TheBl0ckedchain/snake_hardware/ros2_ws/src/snakebot_description/meshes/seg2.stl

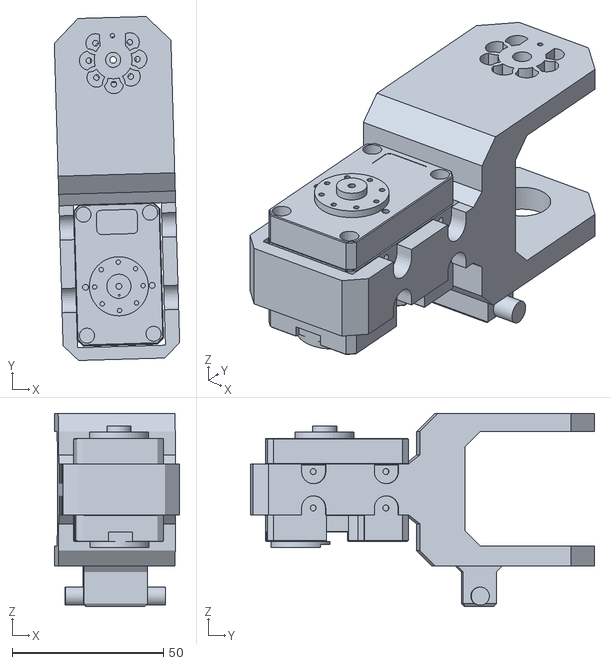
[picture p1: CAD file, 2026-10-05]
ros2_ws/src/snakebot_description/meshes/seg2.stl
41.4 x 113.5 x 63.8
