TheBl0ckedchain/snake_hardware/ros2_ws/src/snakebot_description/meshes/tail.stl

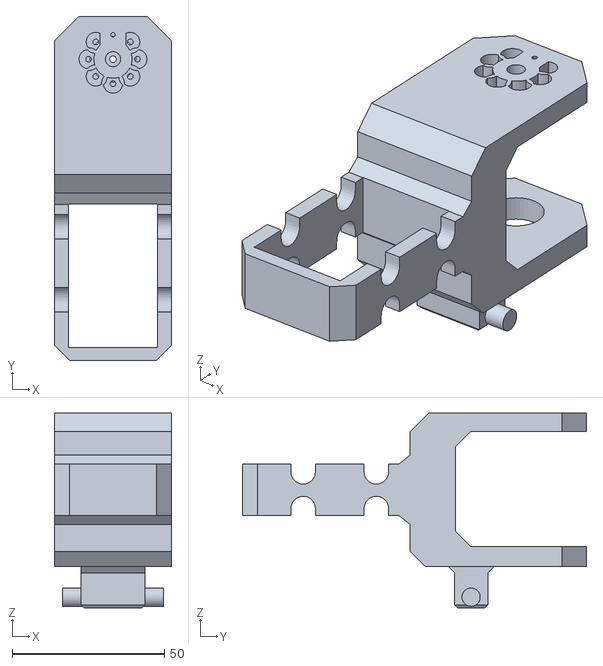
[picture p2: CAD file, 2026-10-05]
ros2_ws/src/snakebot_description/meshes/tail.stl
38.5 x 112.9 x 63.9
