TheBl0ckedchain/snake_hardware/ros2_ws/src/snakebot_description/meshes/base_link.stl

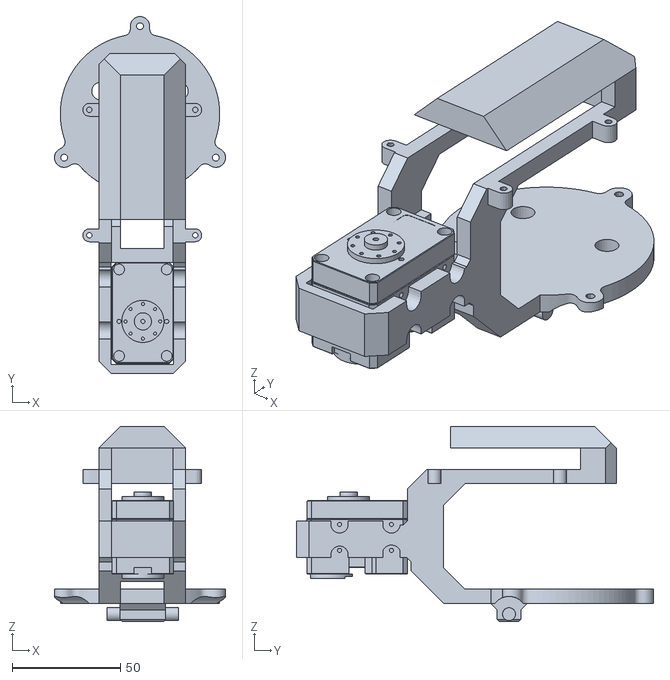
[picture p3: CAD file, 2026-10-05]
ros2_ws/src/snakebot_description/meshes/base_link.stl
79.1 x 165.1 x 90.3
