TheBl0ckedchain/snake_hardware/(list of files, cad)

Other CAD files:
ros2_ws/src/snakebot_description/meshes/seg1.stl
ros2_ws/src/snakebot_description/meshes/seg5.stl
ros2_ws/src/snakebot_description/meshes/seg3.stl
ros2_ws/src/snakebot_description/meshes/seg4.stl
