TheBl0ckedchain/snake_hardware/ros2_ws/src/snakebot_description/urdf/snakebot_core.xacro

<?xml version="1.0"?>
<!-- AUTO-GENERATED by gen.py from the Fusion meshes. Edit snakebot.urdf.xacro for settings. -->
<robot xmlns:xacro="http://www.ros.org/wiki/xacro">

  <link name="base_link">
    <inertial>
      <origin xyz="0.051785 0.000018 0.046945" rpy="0 0 0"/>
      <mass value="${m_base_link}"/>
      <inertia ixx="9.0997e-05" iyy="2.9248e-04" izz="2.3976e-04" ixy="-1.4474e-06" ixz="-1.3283e-05" iyz="6.0904e-07"/>
    </inertial>
    <visual>
      <origin xyz="0.000000 0.000000 0.000000" rpy="0 0 ${-pi/2}"/>
      <geometry><mesh filename="file://$(find snakebot_description)/meshes/base_link.stl" scale="0.001 0.001 0.001"/></geometry>
      <material name="${color_head}"/>
    </visual>
    <collision>
      <origin xyz="0.000000 0.000000 0.000000" rpy="0 0 ${-pi/2}"/>
      <geometry><mesh filename="file://$(find snakebot_description)/meshes/base_link.stl" scale="0.001 0.001 0.001"/></geometry>
    </collision>
  </link>

  <link name="seg1">
    <inertial>
      <origin xyz="-0.049115 -0.001257 -0.022258" rpy="0 0 0"/>
      <mass value="${m_seg1}"/>
      <inertia ixx="2.8940e-05" iyy="8.5347e-05" izz="7.5605e-05" ixy="-1.4134e-06" ixz="3.7939e-06" iyz="9.2217e-08"/>
    </inertial>
    <visual>
      <origin xyz="-0.001587 0.000408 -0.064200" rpy="0 0 ${-pi/2}"/>
      <geometry><mesh filename="file://$(find snakebot_description)/meshes/seg1.stl" scale="0.001 0.001 0.001"/></geometry>
      <material name="${color_body}"/>
    </visual>
    <collision>
      <origin xyz="-0.001587 0.000408 -0.064200" rpy="0 0 ${-pi/2}"/>
      <geometry><mesh filename="file://$(find snakebot_description)/meshes/seg1.stl" scale="0.001 0.001 0.001"/></geometry>
    </collision>
  </link>

  <link name="seg2">
    <inertial>
      <origin xyz="-0.048999 -0.001339 -0.022228" rpy="0 0 0"/>
      <mass value="${m_seg2}"/>
      <inertia ixx="2.8940e-05" iyy="8.5347e-05" izz="7.5605e-05" ixy="-1.4134e-06" ixz="3.7939e-06" iyz="9.2217e-08"/>
    </inertial>
    <visual>
      <origin xyz="0.073255 0.002218 -0.063800" rpy="0 0 ${-pi/2}"/>
      <geometry><mesh filename="file://$(find snakebot_description)/meshes/seg2.stl" scale="0.001 0.001 0.001"/></geometry>
      <material name="${color_body}"/>
    </visual>
    <collision>
      <origin xyz="0.073255 0.002218 -0.063800" rpy="0 0 ${-pi/2}"/>
      <geometry><mesh filename="file://$(find snakebot_description)/meshes/seg2.stl" scale="0.001 0.001 0.001"/></geometry>
    </collision>
  </link>

  <link name="seg3">
    <inertial>
      <origin xyz="-0.048998 -0.001262 -0.022198" rpy="0 0 0"/>
      <mass value="${m_seg3}"/>
      <inertia ixx="2.8939e-05" iyy="8.5348e-05" izz="7.5605e-05" ixy="-1.3948e-06" ixz="3.7939e-06" iyz="9.0963e-08"/>
    </inertial>
    <visual>
      <origin xyz="0.147982 0.004171 -0.063400" rpy="0 0 ${-pi/2}"/>
      <geometry><mesh filename="file://$(find snakebot_description)/meshes/seg3.stl" scale="0.001 0.001 0.001"/></geometry>
      <material name="${color_body}"/>
    </visual>
    <collision>
      <origin xyz="0.147982 0.004171 -0.063400" rpy="0 0 ${-pi/2}"/>
      <geometry><mesh filename="file://$(find snakebot_description)/meshes/seg3.stl" scale="0.001 0.001 0.001"/></geometry>
    </collision>
  </link>

  <link name="seg4">
    <inertial>
      <origin xyz="-0.049109 -0.001245 -0.022168" rpy="0 0 0"/>
      <mass value="${m_seg4}"/>
      <inertia ixx="2.8938e-05" iyy="8.5349e-05" izz="7.5605e-05" ixy="-1.3578e-06" ixz="3.7940e-06" iyz="8.8479e-08"/>
    </inertial>
    <visual>
      <origin xyz="0.222600 0.006022 -0.063000" rpy="0 0 ${-pi/2}"/>
      <geometry><mesh filename="file://$(find snakebot_description)/meshes/seg4.stl" scale="0.001 0.001 0.001"/></geometry>
      <material name="${color_body}"/>
    </visual>
    <collision>
      <origin xyz="0.222600 0.006022 -0.063000" rpy="0 0 ${-pi/2}"/>
      <geometry><mesh filename="file://$(find snakebot_description)/meshes/seg4.stl" scale="0.001 0.001 0.001"/></geometry>
    </collision>
  </link>

  <link name="seg5">
    <inertial>
      <origin xyz="-0.049078 -0.001138 -0.022238" rpy="0 0 0"/>
      <mass value="${m_seg5}"/>
      <inertia ixx="2.8934e-05" iyy="8.5353e-05" izz="7.5605e-05" ixy="-1.2725e-06" ixz="3.7941e-06" iyz="8.2740e-08"/>
    </inertial>
    <visual>
      <origin xyz="0.297361 0.007873 -0.062700" rpy="0 0 ${-pi/2}"/>
      <geometry><mesh filename="file://$(find snakebot_description)/meshes/seg5.stl" scale="0.001 0.001 0.001"/></geometry>
      <material name="${color_body}"/>
    </visual>
    <collision>
      <origin xyz="0.297361 0.007873 -0.062700" rpy="0 0 ${-pi/2}"/>
      <geometry><mesh filename="file://$(find snakebot_description)/meshes/seg5.stl" scale="0.001 0.001 0.001"/></geometry>
    </collision>
  </link>

  <link name="tail">
    <inertial>
      <origin xyz="-0.033705 -0.000052 -0.023434" rpy="0 0 0"/>
      <mass value="${m_tail}"/>
      <inertia ixx="3.0193e-05" iyy="5.9335e-05" izz="4.8131e-05" ixy="1.8217e-13" ixz="1.8038e-06" iyz="-1.9926e-14"/>
    </inertial>
    <visual>
      <origin xyz="0.372127 0.009478 -0.062300" rpy="0 0 ${-pi/2}"/>
      <geometry><mesh filename="file://$(find snakebot_description)/meshes/tail.stl" scale="0.001 0.001 0.001"/></geometry>
      <material name="${color_body}"/>
    </visual>
    <collision>
      <origin xyz="0.372127 0.009478 -0.062300" rpy="0 0 ${-pi/2}"/>
      <geometry><mesh filename="file://$(find snakebot_description)/meshes/tail.stl" scale="0.001 0.001 0.001"/></geometry>
    </collision>
  </link>

  <joint name="joint1" type="revolute">
    <parent link="base_link"/>
    <child link="seg1"/>
    <origin xyz="0.001587 -0.000408 0.064200" rpy="0 0 0"/>
    <axis xyz="0 0 1"/>
    <limit lower="${-joint_limit}" upper="${joint_limit}" effort="${joint_effort}" velocity="${joint_velocity}"/>
    <dynamics damping="${joint_damping}" friction="${joint_friction}"/>
  </joint>

  <joint name="joint2" type="revolute">
    <parent link="seg1"/>
    <child link="seg2"/>
    <origin xyz="-0.074842 -0.001809 -0.000400" rpy="0 0 0"/>
    <axis xyz="0 0 1"/>
    <limit lower="${-joint_limit}" upper="${joint_limit}" effort="${joint_effort}" velocity="${joint_velocity}"/>
    <dynamics damping="${joint_damping}" friction="${joint_friction}"/>
  </joint>

  <joint name="joint3" type="revolute">
    <parent link="seg2"/>
    <child link="seg3"/>
    <origin xyz="-0.074728 -0.001953 -0.000400" rpy="0 0 0"/>
    <axis xyz="0 0 1"/>
    <limit lower="${-joint_limit}" upper="${joint_limit}" effort="${joint_effort}" velocity="${joint_velocity}"/>
    <dynamics damping="${joint_damping}" friction="${joint_friction}"/>
  </joint>

  <joint name="joint4" type="revolute">
    <parent link="seg3"/>
    <child link="seg4"/>
    <origin xyz="-0.074618 -0.001851 -0.000400" rpy="0 0 0"/>
    <axis xyz="0 0 1"/>
    <limit lower="${-joint_limit}" upper="${joint_limit}" effort="${joint_effort}" velocity="${joint_velocity}"/>
    <dynamics damping="${joint_damping}" friction="${joint_friction}"/>
  </joint>

  <joint name="joint5" type="revolute">
    <parent link="seg4"/>
    <child link="seg5"/>
    <origin xyz="-0.074761 -0.001851 -0.000300" rpy="0 0 0"/>
    <axis xyz="0 0 1"/>
    <limit lower="${-joint_limit}" upper="${joint_limit}" effort="${joint_effort}" velocity="${joint_velocity}"/>
    <dynamics damping="${joint_damping}" friction="${joint_friction}"/>
  </joint>

  <joint name="joint6" type="revolute">
    <parent link="seg5"/>
    <child link="tail"/>
    <origin xyz="-0.074766 -0.001606 -0.000400" rpy="0 0 0"/>
    <axis xyz="0 0 1"/>
    <limit lower="${-joint_limit}" upper="${joint_limit}" effort="${joint_effort}" velocity="${joint_velocity}"/>
    <dynamics damping="${joint_damping}" friction="${joint_friction}"/>
  </joint>

  <!-- Raspberry Pi 5 (placed on top of the head hood; box approximation) -->
  <joint name="pi5_joint" type="fixed">
    <parent link="base_link"/>
    <child link="pi5"/>
    <origin xyz="0.087012 -0.000089 0.103085" rpy="0 0 0"/>
  </joint>
  <link name="pi5">
    <inertial>
      <mass value="${m_pi5}"/>
      <inertia ixx="${m_pi5*(0.056**2+0.017**2)/12}" iyy="${m_pi5*(0.085**2+0.017**2)/12}" izz="${m_pi5*(0.085**2+0.056**2)/12}" ixy="0" ixz="0" iyz="0"/>
    </inertial>
    <visual>
      <geometry><box size="0.085 0.056 0.017"/></geometry>
      <material name="pcb_green"/>
    </visual>
  </link>

  <!-- YDLIDAR G2 on the round mount plate of the head -->
  <joint name="lidar_joint" type="fixed">
    <parent link="base_link"/>
    <child link="lidar"/>
    <origin xyz="0.097492 0.000960 0.019335" rpy="0 0 0"/>
  </joint>
  <link name="lidar">
    <inertial>
      <origin xyz="0 0 ${lidar_body_h/2}"/>
      <mass value="${m_lidar}"/>
      <inertia ixx="${m_lidar*(3*lidar_body_r**2+lidar_body_h**2)/12}" iyy="${m_lidar*(3*lidar_body_r**2+lidar_body_h**2)/12}" izz="${m_lidar*lidar_body_r**2/2}" ixy="0" ixz="0" iyz="0"/>
    </inertial>
    <visual>
      <origin xyz="0 0 ${lidar_body_h/2}"/>
      <geometry><cylinder radius="${lidar_body_r}" length="${lidar_body_h}"/></geometry>
      <material name="black"/>
    </visual>
  </link>

  <!-- laser frame: scan plane. x = lidar zero angle (G2: direction of the cable outlet) -->
  <joint name="laser_joint" type="fixed">
    <parent link="lidar"/>
    <child link="laser"/>
    <origin xyz="0 0 ${lidar_scan_height}" rpy="0 0 ${lidar_yaw}"/>
  </joint>
  <link name="laser"/>

</robot>
