TheBl0ckedchain/snake_hardware/ros2_ws/src/snake_driver/config/dxl.yaml

# Dynamixel joint driver. Joints 1-6 run head -> tail; 0 rad = straight (raw position 2048).
dxl_node:
  ros__parameters:
    port: /dev/dynamixel
    baudrate: 1000000          # set by scripts/dxl_configure.py
    ids: [1, 2, 3, 4, 5, 6]
    joint_names: [joint1, joint2, joint3, joint4, joint5, joint6]   # as in snakebot_description
    rate_hz: 100.0             # /joint_states rate
    # Raw angle of each joint in the straight pose (scripts/calibrate_joints.py, 2026-10-05).
    zero_offset_deg: [-0.79, 0.85, -1.05, -0.88, -0.53, -0.54]

    # --- Safety. These are applied only when torque is enabled (via ~/enable). ---
    joint_limit_deg: 60.0      # clamp + servo position limits. Stops 2026-10-05: joint1 -70 (hits lidar UART adapter)/+95, others ~+/-100 deg
    profile_velocity_rpm: 30.0 # max joint speed the servo will plan (the gait in slither.py peaks near 7 rpm)
    profile_accel: 50          # raw units (214.577 rev/min^2 each); 0 = unlimited
    pwm_limit_pct: 70.0        # caps motor output, and so the torque, at this % of supply voltage
    current_limit_a: 1.5       # sustained |current| above this ...
    current_limit_time_s: 1.0  # ... for this long -> all torque off (XM430-W350 stalls at ~2.3 A @ 12 V)
    temp_limit_c: 70           # any joint at or above this -> all torque off (servo's own shutdown is 80)
