TheBl0ckedchain/snake_hardware/(commit log)

2026-10-03 install_system_deps: repair interrupted dpkg state before installing
2026-10-03 lidar.launch: start foxglove_bridge on :8765 for headless viewing
2026-10-04 lidar: crop scan to ±140° — rear wedge is blocked by the mounting joint
    The joint behind the G2 returns self-hits at 0.13-0.16 m that SLAM would
    read as an obstacle attached to the robot.
2026-10-04 Servo driver node (torque off by default) and 1 Mbps bus
    - scripts/dxl_configure.py: one-time EEPROM setup (baud 1 Mbps, return delay 0);
    writes no torque/goal registers. Already applied to IDs 1-6.
    - snake_driver/dxl_node: /joint_states at 100 Hz via sync read, /diagnostics at 1 Hz,
    /snake/joint_cmd for targets, ~/enable service. Starts torque off; on enable it applies
    PWM/position/profile limits and holds present position. Trips all torque off on sustained
    over-current, over-temperature, hardware error or lost comms.
    - slither.py and dxl_status.py default to /dev/dynamixel @ 1 Mbps.
    [dxl.yaml, dxl_configure.py, dxl_node.py, dxl_status.py, slither.py]
2026-10-04 Add stage-1 torque hold test (run by the user at the robot)
2026-10-04 Add stage-2 joint direction test (+5 deg per joint, one at a time)
2026-10-05 Add snakebot_description (URDF/meshes from Fusion export), as delivered
    [base_link.stl, controllers.yaml, materials.xacro, seg1.stl, seg2.stl, seg3.stl, seg4.stl, seg5.stl]
2026-10-05 Wire the CAD URDF into the real robot: robot.launch, gait node, e-stop
    - dxl_node: joints named joint1-6 as in snakebot_description; also accepts
    /snake_position_controller/commands (Float64MultiArray) so gait/NN nodes run
    unchanged on mock, Gazebo and the real servos.
    - snake_bringup/robot.launch.py: robot_state_publisher (URDF) + dxl_node + lidar
    (URDF supplies base_link->laser) + Foxglove.
    - snakebot_gait/serpenoid: A*sin(phi + i*beta) + gamma, live params, ramped
    amplitude/bias, clamped, Ctrl-C fades to straight.
    - scripts/torque_off.py: emergency torque off over the bus, no ROS needed.
    - install_system_deps.sh: ros2_control + ros2_controllers for mock mode.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
2026-10-05 Joint zero calibration: interactive read-only script + per-joint offsets in dxl_node
2026-10-05 Apply joint calibration: zero offsets, ±60° joint limit (driver, URDF, gait)
    Measured stops: joint1 -70/+95 deg, joints 2-6 about +/-100 deg. 60 deg keeps a
    10 deg margin on the tightest (joint1 negative side).
    [joint_calibration.yaml, snakebot.urdf.xacro]
2026-10-05 Verify joint 1 direction against URDF with the lidar; note joint1 collision
    [snakebot.urdf.xacro]
2026-10-05 Gait blends in from the actual pose; slither_run.sh for timed, recorded runs
    First real slither (A=0.2 rad, 0.5 Hz): head moved 5.5 cm forward in ~10 s by
    lidar ICP, joints tracked +/-11.2 of +/-11.5 deg, peak 0.14 A, max 37 C.
    The gait used to start from straight, snapping joints from their resting pose
    (up to 17 deg); it now waits for /joint_states and blends over ramp_s.
2026-10-05 SLAM bringup; driver survives serial errors; fix launch arg leak and run script
    - slam.launch.py + config/slam_toolbox.yaml: online async slam_toolbox via the stock
    lifecycle launch; processes a scan every 0.2 s with identity odom (no odometry yet).
    Replaying the first slither bag gives ~4-5 cm forward, matching ICP/CoM (5.6/5.7 cm).
    - dxl_node: serial errors no longer kill the node (a crash would leave servos holding
    with no safety trips). It resets the SDK's stuck busy flag and counts the failure.
    Tested by provoking a port collision: logs, recovers to 100 Hz.
    - robot.launch.py: scope the lidar include; its foxglove:=false leaked and disabled
    the bridge.
    - slither_run.sh: use job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
    [dxl_node.py]
2026-10-19 Keyboard teleop, /cmd_vel steering and NEAT navigation policy
    serpenoid follows /cmd_vel (use_cmd_vel), with head-only bias and head
    amplitude to match the sim. teleop_key drives it over SSH. nn_controller
    runs genome 7945 from 6_joint_snake (exported to JSON, no neat-python
    needed), building the 30 world-fixed beams from SLAM-registered scans.
    [config-feedforward.txt, snake.urdf]
2026-10-19 Turning test: bias +0.15 turns left 25 deg; run script e-stops if dxl_node dies
    bag_displacement.py measures a run by coarse-to-fine ICP between the first
    and last scan. The -0.15 run aborted when the U2D2 dropped off USB; the
    script now watches for dxl_node dying, gives the torque-off service call a
    timeout before falling back to torque_off.py, and sources colcon setup
    without set -u.
